IowaScaledEngineering/snd-squeal/audio/notes.txt

./convert16k
python3 combiner.py
Manually split flangeMix.wav into chunks in clips/
./createHeaders
Move *.h to src/snd-squeal/squeal

Deprecated:
./convert16k
python3 combiner.py
./createMixHeader
Move flangeMix.h to src/snd-squeal/squeal/
