IowaScaledEngineering/snd-squeal/doc/lab/Squealer_ESU.png

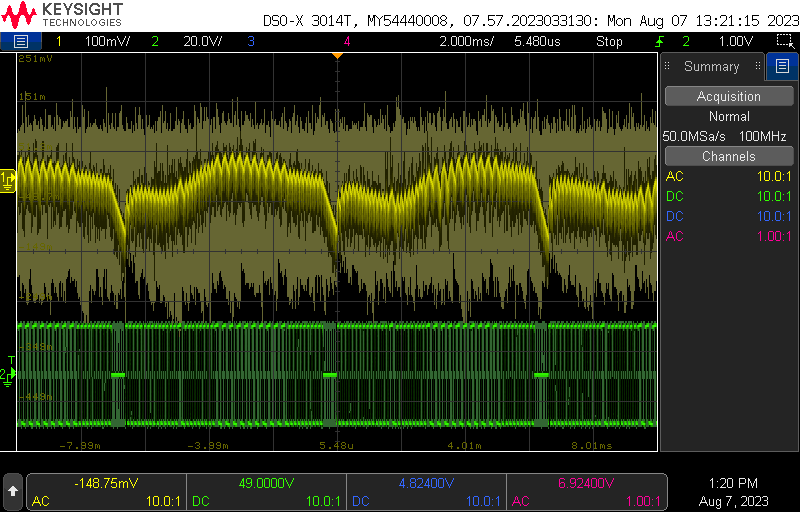
doc/lab/Squealer_ESU.png
