IowaScaledEngineering/snd-squeal/doc/lab/Squealer_NCE.png

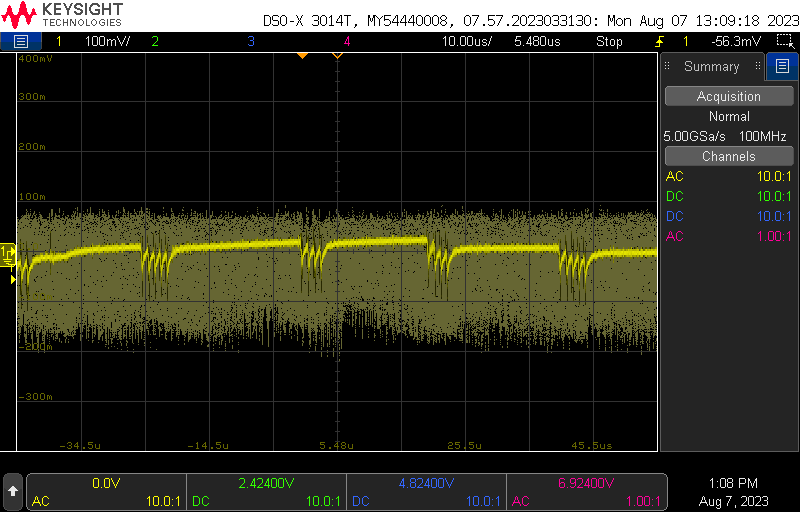
doc/lab/Squealer_NCE.png
