IowaScaledEngineering/snd-squeal/mech/snd-squeal3-insert v10.stl

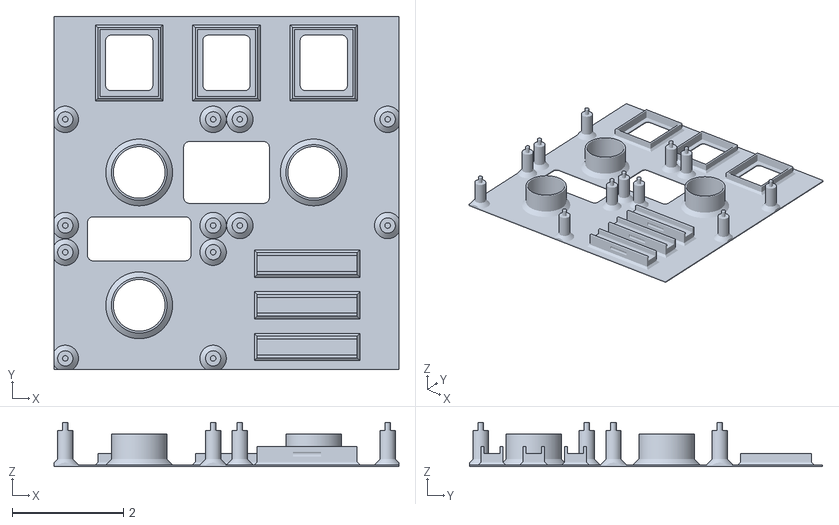
[picture p3: CAD file, 2023-07-15]
mech/snd-squeal3-insert v10.stl
6.20 x 6.35 x 0.8
