IowaScaledEngineering/snd-squeal/mech/snd-squeal-clip v18.stl

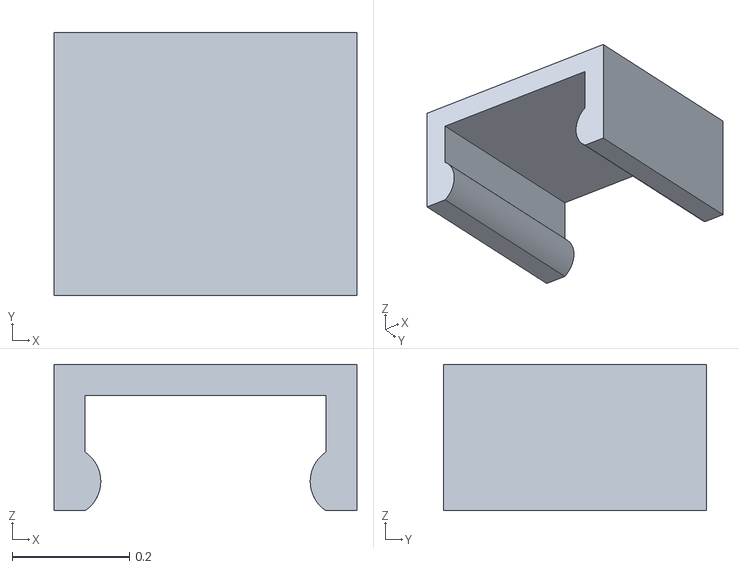
[picture p4: CAD file, 2023-07-15]
mech/snd-squeal-clip v18.stl
0.518 x 0.45 x 0.25
