IowaScaledEngineering/snd-squeal/mech/snd-squeal-insert v18.stl

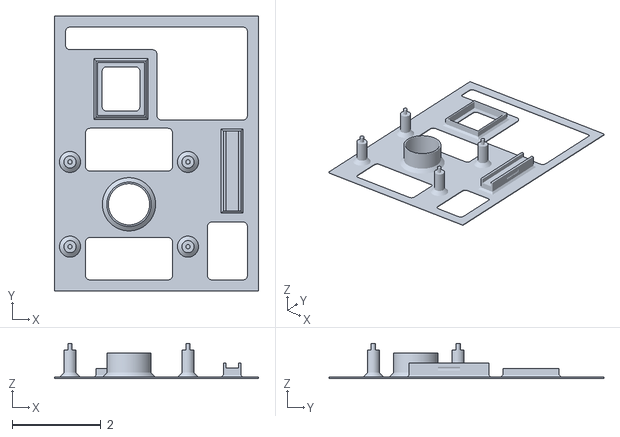
[picture p5: CAD file, 2023-07-15]
mech/snd-squeal-insert v18.stl
4.60 x 6.20 x 0.8
