IowaScaledEngineering/snd-squeal/(commit log)

2023-04-25 Interrupt based volume handling
2023-05-06 Refactored button handling code
2023-05-06 Volume LED updates
2023-05-18 Updated partition table and build process
    [partitions.csv]
2023-05-18 Remove volume prints
2023-05-20 Added bits per sample checking
    [snd-squeal.ods]
2023-05-20 Added board back to Makefile - otherwise it fails the first time
2023-06-20 Changed to direct ESP IDF calls for I2S
    [snd-squeal.ods]
2023-06-22 Fixed muting with not enabled
    [snd-squeal.ino]
2023-07-07 Fixed defaut volume level
    [snd-squeal.ino]
2023-07-15 Box inserts
    [snd-squeal-clip v18.stl, snd-squeal-insert v18.stl, snd-squeal3-insert v10.stl]
2023-07-22 Split into download and print user manual files
2023-08-25 Added support for configuration file. Prevent repeating last sound.
    [snd-squeal.ino]
